liaogx2222/riscv-facerec-soc/提交说明.md

# 工程说明（与赛题提交包同源）

本仓库为**单一 RTL 树**：包含重建全部交付物所需的工程文件。包内默认 RTL 即
五人 QAT 模型配置，直接对应技术报告表4「五人QAT模型版」码流（md5 `b2c404f41db22b83…`）。

## 目录结构

| 目录 | 内容 |
|---|---|
| `rtl/` | 全部 RTL（core 17 / soc 9 / accel 27 / 模型与固件 ROM 15），**默认 = 五人QAT配置** |
| `configs/stable_menu/` | 稳定演示配置的 6 个数据文件（4 模型 ROM + `simple_ram.v` + 仿真金标），按其中 README.txt 覆盖即切换 |
| `constraints/` | 器件/时序/引脚约束（fdc / sdc / pcf，与技术报告表4 码流同一套） |
| `tb/` | 整机与 CoreMark 测试台及金标 |
| `sw/` | 固件 C 源码（门禁 + CoreMark + 菜单） |
| `tools/` | 构建/仿真/校验脚本：`build_flow.py`（一键 RTL→位流）、`synth_vm.py`、`v2_flow.py`、`cmp_sbit.py`、`manifest.py`、`build_menu_fw.py`、`ila_wave.py` 等 |
| `doc/` | 复现手册 `reproduce.md`、时序 `timing.md`、优化 `optimization.md`、权衡 `tradeoff.md` |
| `bitstreams/` | 表4 所列两份最终码流 + `MD5S.txt` |
| `signoff/` | 各配置最终 STA 报告（.rtr）与完整布线资源报告（.rur） |
| `MANIFEST.md` | 输入指纹清单（RTL/约束/固件/测试台 sha256 分组） |

## 复现矩阵（与技术报告表4/表13 对应）

| 码流 | md5 前缀 | 来源 | 包内证据 |
|---|---|---|---|
| facerec_top_menu_line_202p5.sbit（菜单演示版） | `692e2dc77a875` | 开发期候选树工作流（见注） | `signoff/facerec_top_menu_line.rtr/.rur` |
| facerec_top_qat5_202p5.sbit（五人QAT模型版） | `b2c404f41db22b83` | **本包默认配置** | `signoff/facerec_top_qat5.rtr/.rur` |

> 注：菜单版码流由开发期工作流生成（RTL 树已剥离 ILA 观测逻辑），本仓库以码流与 STA 报告的形式提供；
> 其码流与最终 STA 报告作为证据随仓库提供。本包内切到 `configs/stable_menu` 后用同一脚本
> 构建的菜单配置交付树版本时序为 sys +0.260 / cnn +0.126（`All Constraints Met`），
> STA 报告见 `signoff/facerec_top_release_stable.rtr`。

## 快速开始

```bash
# 整机仿真（默认QAT配置，期望 SYSTEM_INTEGRATION_PASS embedding=64/64）
make sim-sys

# 一键 RTL → 位流（2022.2 综合 + 2025.2 布局布线，约 55 分钟）
python tools/build_flow.py rel_build

# 切换到稳定演示配置后构建：先按 configs/stable_menu/README.txt 覆盖 6 个文件，再执行同上命令
```

环境要求与两段式工具链（综合 PDS 2022.2、布局布线 PDS 2025.2）详见 `doc/reproduce.md`。
