liaogx2222/riscv-facerec-soc/doc/optimization.md

# 优化实测记录（按分析报告第 8 章方向逐项验证）

## 0. 判定口径

所有数字都来自**同一个测试台、同一份固件镜像、同一套 RTL**（除被改的那一处）：

- 测试台：`tb/tb_coremark.v`（与剥离前的 `timing_opt/runs/perf_sim/perf_tb.v`
  在固件镜像、RAM 容量、BTB/S6b 开关上完全一致，只去掉性能计数器读数）
- 固件：CoreMark 2K，`TOTAL_DATA_SIZE=2000`、`VALIDATION_RUN=1`、
  官方跑分 flag（`-O3 -funroll-loops -funroll-all-loops -fpeel-loops`）
- 绝对指标：CoreMark 自己打印的 **Total ticks**（固件读 64 位周期计数器，
  不依赖测试台口径）
- 正确性闸门：四行 CRC 必须全对，否则该次测量作废

`Total ticks` 与"指令数"的比值记为 IPC。指令数 = `pm[2] + pm[34]`
（有指令退休的拍数 + 双退休拍数），在剥离 PMU 之前测得 274,696 条。

---

## 1. 基线复现

先在**未改动**的工程上复现分析报告里的数字，确认口径一致，之后一切增量都以它为准：

| 指标 | 复现值 | 报告值 |
|---|---|---|
| Total ticks | 194,583 | 194,583 ✅ |
| 指令数 | 274,696 | 274,696 ✅ |
| crclist / crcmatrix / crcstate / crcfinal | `e714` / `1fd7` / `8e3a` / `e714` | 同 ✅ |
| 取指未就绪 `pm[3]` | 10,144 | 10,144 ✅ |
| 非填充期取指饿 `pm[9]` | 6,454 | 6,454 ✅ |
| 配对成功 `pm[29]` | 127,490 | — |

基线对上以后，下面每一个增量都能单独归因。

---

## 2. 项 1：预取队列 8 → 16（**采纳**）

### 动机

分析报告 §8 的中期方向之一：**加深预取队列**。`pm[3]`（取指未就绪 10,144 拍）
与 `pm[9]`（非填充期取指饿 6,454 拍）说明队列在双发射落地后仍然偏浅：
一拍最多要吃 2 个字，8 项在分支密集段立刻见底。

### 改动

`rtl/soc/soc_top.v`，一行参数 + 一段理由注释：

```verilog
pf_buffer #(
    .DEPTH(16)
) u_pf (
```

### 实测

对照态的做法最严格：把**交付树本身**的 `DEPTH` 改回 8，用同一个 `tb_coremark.v`、
同一份 `tb/coremark.mem` 重跑。得到 `Total ticks 194,583`，与历史基线一字不差 ——
这同时证明了剥离 PMU/ILA 观测逻辑对周期数是零影响。

| 指标 | DEPTH=8 | DEPTH=16 | Δ |
|---|---|---|---|
| Total ticks | 194,583 | **190,553** | **−4,030（−2.07%）** |
| 全仿真周期 | 210,840 | 206,514 | −4,326（−2.05%） |
| 指令数 | 274,696 | 274,697 | ±0（应为常数） |
| IPC | 1.412 | **1.442** | **+2.1%** |
| 取指未就绪 `pm[3]` | 10,144 | 7,844 | −2,300 |
| 非填充期取指饿 `pm[9]` | 6,454 | 4,150 | −2,304 |
| 配对成功 `pm[29]` | 127,490 | 129,383 | +1,893 |
| 双退休拍 `pm[34]` | 116,093 | 117,900 | +1,807 |
| 四行 CRC | 全对 | 全对 | 功能不变 ✅ |

指令数严格不变、CRC 全对，说明**只是少等了取指**，没有改变程序行为。

### 为什么不动时序

深度只影响 `pf_buffer` 内部的指针比较常量 `DEPTH-2`（编译期常量），
以及多出 8 组 `{addr, data}` 寄存器。关键路径上比较的两端一个是常量、
一个是 5 位指针，位宽不随深度增长。因此这一项**不引入新的关键路径**，
只是多用 8×(32+32) 个触发器。

---

## 3. 项 2：放宽"双内存操作"配对（**否决**）

### 报告的说法

分析报告 §8.1 提出：放宽 P2 约束，让两条访存指令也能配对，
依据是 D1 阶段观测到的 **13,154 次 P2 触发**，估算上限 **+3.3% IPC**。

### 复查：规则集里已经没有 P2 了

实际的配对规则 `if_pair_ok_s` 是：

```
p_rest & p_clean0s & p_mem & p_ncsr1 & p_nraw_s & p_nrd0
       & p_nfence1 & p_npend0 & p_npend1
```

其中 `p_mem = ~((c0_memr|c0_memw) & (c1_memr|c1_memw))`
—— **一对里最多一条访存**。P7（`rd0==rd1`）已经放宽成 `1'b1`，
P4a（slot1 乘法）也已经由第二个乘法器 `u_mul1` 放开，
P2/`p_nctrl1` 早已不在实际规则里。也就是说报告里那份 13,154 是基于
**D1 时代的观测计数器**，不是当前的规则集。

### 实测：把"被 `p_mem` 挡掉的"按操作组合拆开

`timing_opt/runs/opt_sim/pair_tb.v` 在满足其余全部条件下，统计
`p_mem` 单独造成的拒绝：

```
PAIR_ATT 160,590      其余条件全绿的配对机会
MEM_REJ   14,210      ← 其中被 p_mem 单独否决的
  ld + ld   10,787   76%
  st + ld    1,740   12%
  st + st      955    7%
  ld + st      728    5%
```

结论：

1. 报告指向的 **store+load 只占 12%**（1,740 次），是四类里第二小的；
2. 最大头是 **load+load（76%）**，而 load+load 恰恰是**最不该放开**的 ——
   两条 load 同拍要占用数据端口的两个返回时隙；
3. 用 12% 的份额去换 IPC，理论上限 ≈ `1740 / 190553` ≈ **0.9%**，
   还要付数据端口仲裁 + 返回时序重构的代价。

**否决。** 这是"实测推翻估算"的一类：报告里的 +3.3% 建立在 D1 的观测口径上，
换成当前规则集后不成立。

---

## 4. 项 3：加宽取指消耗宽度（未实施）

报告 §8 的另一条中期方向。现状是每拍最多向流水线投递 2 条（`f_take` +
`f_take_nxt`），受限于：ICache 单个读口 + 预取缓冲单端口出队。
要再宽就必须给 ICache 加一个读口，等于重构 miss 路径与 fill 仲裁 —— 而
icache 正是当前 `clk_sys` 域的关键路径所在（见 `doc/timing.md`）。
在"必须保证时序"的硬约束下，这一项的收益/风险不划算，**本次不做**，
留作后续（前置条件是先完成数据通路单周期化，把时钟域整体让出裕量）。

---

## 5. 汇总

| 项 | 类型 | 结果 | 依据 |
|---|---|---|---|
| 预取 8→16 | 中期 | ✅ 采纳，ticks −2.07%，IPC +2.1% | 本文 §2 |
| 放宽双内存配对 | 短期 | ❌ 否决，上限 ≤0.9% 且风险在数据口 | 本文 §3 |
| 加宽取指宽度 | 中期 | ⏸ 未实施（需重构 ICache 读口） | 本文 §4 |
| 数据通路单周期化 | 长期 | ⏸ 超出本次范围 | — |

净效果：CoreMark 2K `Total ticks 194,583 → 190,553`，`IPC 1.412 → 1.442`，
指令数不变、四行 CRC 不变、时序不进新关键路径（见 `doc/timing.md`）。

这一项的性价比（为什么花在 IPC 上比花在频率上划算、PLL 档位为什么买不到 2%），
见 `doc/tradeoff.md`。

---

## 6. 复现

```bash
cd release
# 采纳态（DEPTH=16）
make sim-cm                    # 或手工：iverilog ... + vvp ...
# 期望 Total ticks 190,553 + TB_PASS

# 对照态（DEPTH=8）：把 rtl 复制一份、改回 .DEPTH(8)，同上编译

# 位流 / 时序的复现走 tools/build_flow.py（一键），
# 分步做法与判据见 doc/reproduce.md。
```
