liaogx2222/riscv-facerec-soc/doc/tradeoff.md

# 频率 ↔ 性能的 tradeoff（含本轮优化的实测归因）

## 0. 一句话结论

这颗芯片的频率**已经签核到布线级**（`All Constraints Met.`，CPU +4.16% / CNN +2.34%
的周期余量），但**再往上走一步是买不到的** —— PLL 的下一档是 +6.67%，一步就跨过了
全部余量。所以这轮性能只能从 IPC 里拿：预取队列 8→16 换来 **+2.07%**，
等于把频率从 101.25 抬到 **103.39 MHz**，而频率预算**一分没动**。

---

## 1. 性能的两个乘数

一輪 CoreMark 2K 的墙钟时间：

```
T = ticks / f = (指令数 / IPC) / f
```

- `ticks`（= 190,553）由微架构决定，改 RTL 才能动；
- `f` 由关键路径 + 布局布线 + **PLL 分频比**共同决定。

两者在分数上等价：`f` 提 2.07% 与 `ticks` 降 2.07%，CoreMark 分数完全一样
（`CM/MHz = 1e6/ticks`，`分数 = CM/MHz × f`）。所以真正的问题是"哪一种买得到"。

| 路径 | 手段 | 收益 | 代价 |
|---|---|---|---|
| 买频率 | 把 101.25 抬到 103.4 MHz | +2.07% | 需要 **+2.07%** 周期余量，且 PLL 必须能出这个频点 |
| 买 IPC | 预取队列 8→16 | +2.07% | 512 个触发器，关键路径不变 |

下面两节分别算这两笔账，结论是**第二笔买得到，第一笔买不到**。

---

## 2. 频率那一侧：有余量，但没有"台阶"

### 2.1 余量（布线签核实测，2025.2 引擎）

| 时钟 | 请求 | 实测 | 周期余量 | 折算频率余量 |
|---|---|---|---|---|
| `clk_sys` | 9.8765 ns（101.25 MHz） | **9.4815 ns** | **+0.395 ns** | 105.47 MHz，**+4.16%** |
| `clk_cnn` | 4.9383 ns（202.5 MHz） | **4.8253 ns** | **+0.113 ns** | 207.24 MHz，**+2.34%** |

余量是真实存在的（不是"欠 80 ps"——那个数字来自 2022.2 引擎的一次
`-place_only` 筛选，跨引擎不可比，见 `doc/timing.md` §4）。

### 2.2 但频率是"量子化"的

PLL 是硬连线整数分频：`VCO = 27 MHz × M × F`（F 按 1/8 步进，VCO ∈ [600, 1200]），
`clk_sys = VCO/8`、`clk_cnn = VCO/4`（严格 2:1）。当前 `M=10, F=3 → VCO 810`。

往上找最近的合法档：

| VCO | M / F | clk_sys | 相对 101.25 | 需要 CPU 余量 | 需要 CNN 余量 |
|---|---|---|---|---|---|
| **810（当前）** | 10 / 3.0 | 101.25 MHz | — | 0 | 0 |
| **864** | **8 / 4.0** | **108.00 MHz** | **+6.67%** | 6.67% > 4.16% ❌ | 6.67% > 2.34% ❌ |
| 891 | 11 / 3.0 | 111.375 MHz | +10.0% | ❌ | ❌ |
| 1080 | 10 / 4.0 | 135.00 MHz | +33.3% | ❌ | ❌ |

**最小的可用台阶是 +6.67%，而余量只有 +4.16%（CPU）/ +2.34%（CNN）。**
也就是说：频率不是"能提多少提多少"，而是要么原地不动，要么一步跳到 108 MHz
然后把余量烧穿。**这条路上没有 2% 的增量可买。**

（顺带解释了为什么 148.5/297 MHz 这个档位也走不通：`VCO=1188` 是最高合法档，
但 297 MHz 需要 3.367 ns、实测最好 4.8253 ns，差 43%；而且把约束压紧到 297，
CNN 反而从 4.8253 退化到 5.1750 —— 无解区间里约束收紧是负收益。）

### 2.3 结论

频率这一侧的正确用法不是"再挤一点"，而是"**守住已签核的余量**"：
+0.395 / +0.113 ns 是布线后剩下来的安全垫，用来吸收温度、电压、
以及后续任何一处改动的扰动。拿它去换 2% 的分数，等于把安全垫烧掉，
换来的只是一次跳档失败的风险。

---

## 3. IPC 那一侧：这才是可增量购买的性能

| 项 | 基线 | 优化后 | Δ |
|---|---|---|---|
| Total ticks | 194,583 | **190,553** | **−4,030（−2.07%）** |
| 指令数 | 274,696 | 274,697 | ±0（应为常数） |
| IPC | 1.4117 | **1.4416** | **+2.12%** |
| CM/MHz（=1e6/ticks） | 5.1392 | **5.2479** | +2.12% |
| 分数 @101.25 MHz | 520.3 | **531.3** | +11.0 |
| 分数 @27 MHz | 138.8 | 141.7 | +2.9 |

换算成"等价的频率"：**103.39 MHz**。也就是说，这一项优化让设计在
101.25 MHz 上跑出了 103.39 MHz 的分数，而没有向时序要任何东西：

- 关键路径上 `pf_buffer` 比较的是**编译期常量** `DEPTH-2`，另一侧是 5 位指针，
  位宽不随深度增长 ⇒ 不产生新的关键路径；
- 新增硬件 = 8 组 `{addr,data}` = **512 个 FF**，BRAM 数量不变；
- 副作用全是好的：取指未就绪 10,144→7,844 拍、非填满期取指饿 6,454→4,150 拍。

在频率-性能这张图上，它是**纯向右平移**（性能↑，频率不变），
而不是沿着曲线滑动。

---

## 4. 三个档位，各自的代价

| 档位 | CPU / CNN | CoreMark 一轮 | 6000 次迭代 | 时序状态 | 定位 |
|---|---|---|---|---|---|
| **产品（签核）** | 101.25 / 202.5 MHz | 1.882 ms | ≈11.3 s | ✅ 布线 `All Constraints Met.`（+0.395 / +0.113） | 正式参赛/演示 |
| **27 MHz 保底** | 27 / 27 MHz（PLL 旁路） | 7.058 ms | ≈42.3 s | ✅ 仅 CPU-only 签核过（+14.080 ns） | 现场救急 |
| **CNN 降频** | 101.25 / ≈204 MHz | 1.882 ms | ≈11.3 s | ✅ 若需要把 CNN 余量再加厚 | 备选 |

27 MHz 的账很清楚：周期是产品的 **3.75 倍**，同一份 RTL/固件 CoreMark 一轮
从 1.88 ms 变 7.06 ms，分数从 531 掉到 142（**−73%**）。它的价值不在分数，
在于"一定能跑起来"：PLL 一旦不锁、或高频不收敛，这是唯一还能演示的路径。
赛题要求"单次跑分 ≥10 s"，6000 次迭代在 27 MHz 下 ≈42.3 s，**仍然满足**
（那是下限约束，降频不违规，只是分数低）。

---

## 5. 被否决的那一项，恰好是"收益小、还要动频率"

报告 §8.1 建议放宽"双内存操作"配对。实测把 `p_mem` 单独造成的 14,210 次
拒绝拆开：`ld+ld 10,787（76%）/ st+ld 1,740（12%）/ st+st 955 / ld+st 728`。

- 理论收益上限 ≈ 1,740 / 190,553 ≈ **0.9%**（不到预取那一项的一半）；
- 代价是要让两条访存同拍占用数据端口：返回时隙仲裁、转发优先级、store buffer
  入队条件全部要重排 —— 这些**全在 `clk_sys` 的关键路径上**。

它同时做了两件坏事：收益更小，且**可能把 +0.395 ns 的安全垫吃掉**。
在"必须保证时序"的前提下，正确结论是**否决**，而不是"下次再做"。

---

## 6. 如果还要继续提性能，按这个顺序

| 优先级 | 手段 | 预期收益 | 频率代价 | 风险 |
|---|---|---|---|---|
| 1 | ICache 加第二读口 / 加宽取指消耗 | 争取再 +2~3% IPC | **升高**（icache 在 `clk_sys` 关键路径上） | 中，需重构 miss/fill 仲裁 |
| 2 | 数据通路单周期化（报告 §8 长期项） | 为 1 腾出裕量 | 中性偏降 | 高，等于重做访存流水 |
| 3 | PE 阵列再插流水冲更高 CNN 频率 | CNN 频率 +1.6% 量级 | 降低 | 高，黄金向量要全量回归 |
| — | 改 PLL 分频比直接跳档（108 MHz） | 名义 +6.67% | **超出余量** | 会直接失败，不可行 |

顺序原则：**先动"占频率预算"的改造（1/2），再谈频率；永远不要用"把约束
压紧"来提频** —— 2022.2/2025.2 两次实测都表明在无解区间收紧约束是负收益
（202.5→297，CNN 从 4.8253 退化到 5.1750）。

---

## 7. 落到数字上的总结

```
优化前：194,583 ticks @ 101.25 MHz = 1.9218 ms/轮，IPC 1.4117，分数 520.3
优化后：190,553 ticks @ 101.25 MHz = 1.8820 ms/轮，IPC 1.4416，分数 531.3
```

- 性能 **+2.07%**，等价于 **103.39 MHz**；
- 频率一分没多花（仍是签核的 101.25 / 202.5，余量 +0.395 / +0.113 ns 未动）；
- 指令数 274,696 → 274,697（不变）、四行 CRC 全对（功能不变）；
- 面积 +512 FF；BRAM 不变；关键路径不变。

一句话：**这轮优化的本质，是把"本来要一次跳档 +6.67% 才能买到的性能"，
用 512 个触发器换了回来。** 签核余量一分没动，留给后面真正需要动频率的改造。
