liaogx2222/riscv-facerec-soc/rtl/accel/cnn_linebuf.v

// Banked 4-row line buffer, derived from FaceRec_SoC cnn_linebuf.
// Four logical rows x three interleaved column banks; one read per bank.
// Payload RAM is reset-free; per-word validity implements synchronous clear.
// 3x3 and PW windows remain combinational, with the original cycle protocol.
// Eight-bit coordinate quotient/remainder uses a complete constant lookup,
// avoiding runtime signed division/modulo unsupported by PDS ADS.
// PW selects the center row and wraps c to WAW bits as in the source design.
// Source provenance and equivalence/resource evidence are in doc/ and build/.
`timescale 1ns/1ps

(* syn_romstyle="logic" *) module cnn_linebuf #(
    parameter CH   = 32,
    parameter AW   = 8,
    parameter MAXW = 128,
    parameter TAPS = 9,
    parameter WAW  = 7,           // 列地址位宽（MAXW=128 ⇒ 7）
    parameter RAW  = 9            // 行缓冲地址位宽（4*MAXW=512 ⇒ 9）
)(
    input  wire                    clk,
    input  wire                    rst_n,
    input  wire                    clr,          // 层首/复位：整组清零 + rot_p 归零
    input  wire                    win_top_zero, // 输出行 r==0：窗口顶行（输入行 -1）强制零
    input  wire                    win_bot_zero, // ★ 窗口底行（输入行 r+1 ≥ ih）强制零
                                                 //   —— stride-1 末输出行的底行越界，
                                                 //     调度器仍会装载（读 ACT 越界地址，
                                                 //     数据被这里掩掉），拍数不变
    input  wire                    mode_pw,      // ★ 1 = 1×1 层：窗口退化为 1×1（9 tap 同一列字）
    input  wire                    rot_step2,    // ★ 1 = 每次 rot 前进 2 行（stride-2）；0 = 前进 1 行
    input  wire                    wld,          // 装载一拍（写 row_buf[ldst][waddr]）
    input  wire [1:0]              ldst,         // 装载目标物理行（0..3）
    input  wire [WAW-1:0]          waddr,        // 装载列地址
    input  wire [CH*AW-1:0]        newword,      // 装载数据（CH 字节）
    input  wire                    rot,          // 行旋转
    input  wire [7:0]              iw,           // 本层行宽（运行时；★M8 拓到 8 位）
    input  wire [7:0]              c,            // 当前输出像素列（0..iw-1）
    output wire [1:0]              rot_p_o,      // 行环指针（控制器算装载目标用）
    output reg  [TAPS*CH*AW-1:0]   win           // 组合窗口输出
);

    // Complete eight-bit quotient/remainder table: no runtime div/mod.
    function [8:0] divmod3;
        input [7:0] x;
        begin
            case(x)
                8'd0: divmod3=9'd0;
                8'd1: divmod3=9'd1;
                8'd2: divmod3=9'd2;
                8'd3: divmod3=9'd4;
                8'd4: divmod3=9'd5;
                8'd5: divmod3=9'd6;
                8'd6: divmod3=9'd8;
                8'd7: divmod3=9'd9;
                8'd8: divmod3=9'd10;
                8'd9: divmod3=9'd12;
                8'd10: divmod3=9'd13;
                8'd11: divmod3=9'd14;
                8'd12: divmod3=9'd16;
                8'd13: divmod3=9'd17;
                8'd14: divmod3=9'd18;
                8'd15: divmod3=9'd20;
                8'd16: divmod3=9'd21;
                8'd17: divmod3=9'd22;
                8'd18: divmod3=9'd24;
                8'd19: divmod3=9'd25;
                8'd20: divmod3=9'd26;
                8'd21: divmod3=9'd28;
                8'd22: divmod3=9'd29;
                8'd23: divmod3=9'd30;
                8'd24: divmod3=9'd32;
                8'd25: divmod3=9'd33;
                8'd26: divmod3=9'd34;
                8'd27: divmod3=9'd36;
                8'd28: divmod3=9'd37;
                8'd29: divmod3=9'd38;
                8'd30: divmod3=9'd40;
                8'd31: divmod3=9'd41;
                8'd32: divmod3=9'd42;
                8'd33: divmod3=9'd44;
                8'd34: divmod3=9'd45;
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
                8'd218: divmod3=9'd290;
                8'd219: divmod3=9'd292;
                8'd220: divmod3=9'd293;
                8'd221: divmod3=9'd294;
                8'd222: divmod3=9'd296;
                8'd223: divmod3=9'd297;
                8'd224: divmod3=9'd298;
                8'd225: divmod3=9'd300;
                8'd226: divmod3=9'd301;
                8'd227: divmod3=9'd302;
                8'd228: divmod3=9'd304;
                8'd229: divmod3=9'd305;
                8'd230: divmod3=9'd306;
                8'd231: divmod3=9'd308;
                8'd232: divmod3=9'd309;
                8'd233: divmod3=9'd310;
                8'd234: divmod3=9'd312;
                8'd235: divmod3=9'd313;
                8'd236: divmod3=9'd314;
                8'd237: divmod3=9'd316;
                8'd238: divmod3=9'd317;
                8'd239: divmod3=9'd318;
                8'd240: divmod3=9'd320;
                8'd241: divmod3=9'd321;
                8'd242: divmod3=9'd322;
                8'd243: divmod3=9'd324;
                8'd244: divmod3=9'd325;
                8'd245: divmod3=9'd326;
                8'd246: divmod3=9'd328;
                8'd247: divmod3=9'd329;
                8'd248: divmod3=9'd330;
                8'd249: divmod3=9'd332;
                8'd250: divmod3=9'd333;
                8'd251: divmod3=9'd334;
                8'd252: divmod3=9'd336;
                8'd253: divmod3=9'd337;
                8'd254: divmod3=9'd338;
                8'd255: divmod3=9'd340;
                default: divmod3=9'bxxxxxxxxx;
            endcase
        end
    endfunction

    localparam DW = CH*AW;
    localparam BANK_DEPTH = (MAXW+2)/3;
    localparam BAW = BANK_DEPTH>1 ? $clog2(BANK_DEPTH) : 1;
    reg [1:0] rot_p;
    assign rot_p_o=rot_p;
    always @(posedge clk) begin
        if (!rst_n || clr) rot_p<=0;
        else if (rot) rot_p<=rot_p+(rot_step2 ? 2'd2 : 2'd1);
    end

    // Each physical row has three interleaved column banks. Three adjacent
    // columns use different banks, so every payload array needs one read.
    wire [7:0] ci=mode_pw ? c[WAW-1:0] : c;
    wire [8:0] read_divmod=divmod3(ci);
    wire [6:0] cq=read_divmod[8:2];
    wire [1:0] cr=read_divmod[1:0];
    // Move every RAM operation one edge together. Delaying just the read
    // address would change same-address read/write and clear semantics.
    reg memory_reset_q,memory_clear_q,write_load_q;
    reg [1:0] write_row_q;
    // The original binary address shadow let ADS retime this table into
    // a synchronous DRM ROM. Capture its decoded result in fabric instead.
    wire [8:0] write_decode=divmod3(waddr);
    (* syn_preserve=1, syn_romstyle="logic" *) reg [8:0] write_decode_q;
    (* syn_preserve=1 *) reg write_in_range_q;
    reg [DW-1:0] write_word_q;
    always @(posedge clk)begin
        memory_reset_q<=rst_n;memory_clear_q<=clr;write_load_q<=wld;
        write_row_q<=ldst;write_decode_q<=write_decode;
        write_in_range_q<=waddr<MAXW;write_word_q<=newword;
    end
    wire [8:0] write_divmod=write_decode_q;
    wire [6:0] write_idx=write_divmod[8:2];
    wire [1:0] write_bank=write_divmod[1:0];
    wire [12*DW-1:0] bank_word;
    wire [11:0] bank_valid;
    genvar row,bank;
    generate for(row=0;row<4;row=row+1) begin:g_row
        // Keep the scalar validity address off the 256-bit payload fanout.
        wire [3*BAW-1:0] valid_read_indexes;
        // ADS compiles away equivalent instances despite syn_hier="hard".
        // Official syn_noprune is verified by the decoder attribute probe.
        (* syn_noprune=1 *) cnn_linebuf_read_addr #(.WAW(WAW),.BANK_DEPTH(BANK_DEPTH),.BAW(BAW)) u_valid_addr(
            .c(c),.mode_pw(mode_pw),.indexes(valid_read_indexes));
        wire [3*BAW-1:0] row_read_indexes;
        cnn_linebuf_read_addr #(.WAW(WAW),.BANK_DEPTH(BANK_DEPTH),.BAW(BAW)) u_addr(
            .c(c),.mode_pw(mode_pw),.indexes(row_read_indexes));
        (* syn_preserve=1 *) reg [3*BAW-1:0] payload_indexes_q;
        (* syn_preserve=1 *) reg [3*BAW-1:0] validity_indexes_q;
        always @(posedge clk)begin
            payload_indexes_q<=row_read_indexes;
            validity_indexes_q<=valid_read_indexes;
        end
        for(bank=0;bank<3;bank=bank+1) begin:g_bank
            reg [DW-1:0] payload[0:BANK_DEPTH-1] /* synthesis syn_ramstyle="select_ram" */;
            reg [BANK_DEPTH-1:0] valid;
            wire wen=write_load_q && write_row_q==row && write_bank==bank && write_in_range_q;
            always @(posedge clk)
                if(memory_reset_q && !memory_clear_q && wen) payload[write_idx[BAW-1:0]]<=write_word_q;
            always @(posedge clk) begin
                if(!memory_reset_q || memory_clear_q) valid<=0;
                else if(wen) valid[write_idx[BAW-1:0]]<=1'b1;
            end
            reg [DW-1:0] read_q;
            reg read_valid_q;
            // Sample payload and its validity at the same edge. Applying
            // the zero mask afterwards preserves read-before-write and
            // four-state semantics, without a wide synchronous-reset cone.
            always @(posedge clk) begin
                read_q <= payload[payload_indexes_q[bank*BAW+:BAW]];
                read_valid_q <= valid[validity_indexes_q[bank*BAW+:BAW]];
            end
            assign bank_word[(row*3+bank)*DW +: DW]=read_q;
            assign bank_valid[row*3+bank]=read_valid_q;
        end
    end endgenerate

    // Register decoded selectors/masks alongside the bank data. Boundary
    // comparison and coordinate arithmetic no longer precede DSP input setup.
    localparam NREADROWS=(TAPS+2)/3;
    reg [1:0] row_d[0:NREADROWS-1],row_q[0:NREADROWS-1];
    reg [1:0] col_d[0:2],col_q[0:2];
    integer init_i;
    reg [TAPS-1:0] keep_d,keep_q;
    integer t,tr,tc,bank_tmp,scol;
    reg [1:0] physical_row,column_bank;
    reg [3:0] data_index;
    always @(*) begin
        keep_d=0;tr=0;tc=0;physical_row=0;column_bank=0;
        bank_tmp=0;scol=0;data_index=0;
        for(init_i=0;init_i<NREADROWS;init_i=init_i+1)row_d[init_i]=0;
        for(init_i=0;init_i<3;init_i=init_i+1)col_d[init_i]=0;
        for(t=0;t<TAPS;t=t+1) begin
            tr=t/3;tc=t%3;
            if(mode_pw) begin
                physical_row=(rot_p+1)&3;column_bank=cr;
                data_index={physical_row,1'b0}+physical_row+column_bank;
                row_d[tr]=physical_row;col_d[tc]=column_bank;keep_d[t]=1'b1;
            end else begin
                physical_row=(rot_p+tr)&3;
                bank_tmp=cr+tc-1;
                if(bank_tmp<0) bank_tmp=bank_tmp+3;
                if(bank_tmp>=3) bank_tmp=bank_tmp-3;
                column_bank=bank_tmp[1:0];scol=ci+tc-1;
                data_index={physical_row,1'b0}+physical_row+column_bank;
                row_d[tr]=physical_row;col_d[tc]=column_bank;
                // Procedural if preserves the reference's four-state mask
                // behavior, including unknown boundary control inputs.
                if((win_top_zero && tr==0)||(win_bot_zero && tr==2)||scol<0||scol>=iw)
                    keep_d[t]=1'b0;
                else keep_d[t]=1'b1;
            end
        end
    end
    reg [1:0] row_index_q[0:NREADROWS-1],col_index_q[0:2];
    reg [TAPS-1:0] keep_index_q;
    integer k;
    always @(posedge clk) begin
        for(k=0;k<NREADROWS;k=k+1)begin row_index_q[k]<=row_d[k];row_q[k]<=row_index_q[k];end
        for(k=0;k<3;k=k+1)begin col_index_q[k]<=col_d[k];col_q[k]<=col_index_q[k];end
        keep_index_q<=keep_d;keep_q<=keep_index_q;
    end
    reg [1:0] col_pipe_q[0:2];
    reg [TAPS-1:0] keep_pipe_q;
    integer pipe_col;
    always @(posedge clk)begin
        for(pipe_col=0;pipe_col<3;pipe_col=pipe_col+1)col_pipe_q[pipe_col]<=col_q[pipe_col];
        keep_pipe_q<=keep_q;
    end
    wire [TAPS*DW-1:0] window_word;
    genvar rr,bb,cc;
    generate for(rr=0;rr<NREADROWS;rr=rr+1)begin:g_read_row
        wire [3*DW-1:0] logical_banks;
        reg [3*DW-1:0] logical_banks_q;
        always @(posedge clk)logical_banks_q<=logical_banks;
        for(bb=0;bb<3;bb=bb+1)begin:g_read_bank
            cnn_lb_row_pick #(.DW(DW)) u_pick(
                .words({bank_word[(9+bb)*DW+:DW],bank_word[(6+bb)*DW+:DW],
                        bank_word[(3+bb)*DW+:DW],bank_word[bb*DW+:DW]}),
                .valids({bank_valid[9+bb],bank_valid[6+bb],bank_valid[3+bb],bank_valid[bb]}),
                .sel(row_q[rr]),.value(logical_banks[bb*DW+:DW]));
        end
        for(cc=0;cc<3;cc=cc+1)begin:g_read_col
            if(rr*3+cc<TAPS)begin:g_tap
                cnn_lb_col_pick #(.DW(DW)) u_pick(.words(logical_banks_q),
                    .sel(col_pipe_q[cc]),.value(window_word[(rr*3+cc)*DW+:DW]));
            end
        end
    end endgenerate
    integer o;
    always @(*) begin
        win=0;
        for(o=0;o<TAPS;o=o+1) begin
            if(!keep_pipe_q[o]) win[o*DW+:DW]=0;
            else win[o*DW+:DW]=window_word[o*DW+:DW];
        end
    end
endmodule

// Final bank indexes are constant functions of c and PW wrap semantics.
module cnn_linebuf_read_addr /* synthesis syn_hier="hard" */ #(
    parameter WAW=7,BANK_DEPTH=43,BAW=6)(
    input wire [7:0] c,input wire mode_pw,output wire [3*BAW-1:0] indexes);
    function [BAW-1:0] bound;
        input integer n;
        begin if(n>=0 && n<BANK_DEPTH)bound=n;else bound=0;end
    endfunction
    function [3*BAW-1:0] decode_read;
        input [7:0] coordinate;input pw;
        begin
        case({pw,coordinate})
            9'd0:decode_read={bound(-1),bound(0),bound(0)};
            9'd1:decode_read={bound(0),bound(0),bound(0)};
            9'd2:decode_read={bound(0),bound(0),bound(1)};
            9'd3:decode_read={bound(0),bound(1),bound(1)};
            9'd4:decode_read={bound(1),bound(1),bound(1)};
            9'd5:decode_read={bound(1),bound(1),bound(2)};
            9'd6:decode_read={bound(1),bound(2),bound(2)};
            9'd7:decode_read={bound(2),bound(2),bound(2)};
            9'd8:decode_read={bound(2),bound(2),bound(3)};
            9'd9:decode_read={bound(2),bound(3),bound(3)};
            9'd10:decode_read={bound(3),bound(3),bound(3)};
            9'd11:decode_read={bound(3),bound(3),bound(4)};
            9'd12:decode_read={bound(3),bound(4),bound(4)};
            9'd13:decode_read={bound(4),bound(4),bound(4)};
            9'd14:decode_read={bound(4),bound(4),bound(5)};
            9'd15:decode_read={bound(4),bound(5),bound(5)};
            9'd16:decode_read={bound(5),bound(5),bound(5)};
            9'd17:decode_read={bound(5),bound(5),bound(6)};
            9'd18:decode_read={bound(5),bound(6),bound(6)};
            9'd19:decode_read={bound(6),bound(6),bound(6)};
            9'd20:decode_read={bound(6),bound(6),bound(7)};
            9'd21:decode_read={bound(6),bound(7),bound(7)};
            9'd22:decode_read={bound(7),bound(7),bound(7)};
            9'd23:decode_read={bound(7),bound(7),bound(8)};
            9'd24:decode_read={bound(7),bound(8),bound(8)};
            9'd25:decode_read={bound(8),bound(8),bound(8)};
            9'd26:decode_read={bound(8),bound(8),bound(9)};
            9'd27:decode_read={bound(8),bound(9),bound(9)};
            9'd28:decode_read={bound(9),bound(9),bound(9)};
            9'd29:decode_read={bound(9),bound(9),bound(10)};
            9'd30:decode_read={bound(9),bound(10),bound(10)};
            9'd31:decode_read={bound(10),bound(10),bound(10)};
            9'd32:decode_read={bound(10),bound(10),bound(11)};
            9'd33:decode_read={bound(10),bound(11),bound(11)};
            9'd34:decode_read={bound(11),bound(11),bound(11)};
            9'd35:decode_read={bound(11),bound(11),bound(12)};
            9'd36:decode_read={bound(11),bound(12),bound(12)};
            9'd37:decode_read={bound(12),bound(12),bound(12)};
            9'd38:decode_read={bound(12),bound(12),bound(13)};
            9'd39:decode_read={bound(12),bound(13),bound(13)};
            9'd40:decode_read={bound(13),bound(13),bound(13)};
            9'd41:decode_read={bound(13),bound(13),bound(14)};
            9'd42:decode_read={bound(13),bound(14),bound(14)};
            9'd43:decode_read={bound(14),bound(14),bound(14)};
            9'd44:decode_read={bound(14),bound(14),bound(15)};
            9'd45:decode_read={bound(14),bound(15),bound(15)};
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
            9'd509:decode_read={bound(((8'd253 & ((1<<WAW)-1))/3)),bound(((8'd253 & ((1<<WAW)-1))/3)),bound(((8'd253 & ((1<<WAW)-1))/3))};
            9'd510:decode_read={bound(((8'd254 & ((1<<WAW)-1))/3)),bound(((8'd254 & ((1<<WAW)-1))/3)),bound(((8'd254 & ((1<<WAW)-1))/3))};
            9'd511:decode_read={bound(((8'd255 & ((1<<WAW)-1))/3)),bound(((8'd255 & ((1<<WAW)-1))/3)),bound(((8'd255 & ((1<<WAW)-1))/3))};
            default:decode_read={3*BAW{1'bx}};
        endcase
        end
    endfunction
    assign indexes=decode_read(c,mode_pw);
endmodule

// Shared 4:1 row selection precedes the three column selections. Keeping
// this hierarchy stops a separate 12:1 mux being rebuilt for every tap.
module cnn_lb_row_pick /* synthesis syn_hier="hard" */ #(parameter DW=256)(
    input wire [4*DW-1:0] words,input wire [3:0] valids,
    input wire [1:0] sel,output wire [DW-1:0] value);
    wire [DW-1:0] raw=words[sel*DW+:DW];
    assign value=valids[sel]?raw:{DW{1'b0}};
endmodule
module cnn_lb_col_pick /* synthesis syn_hier="hard" */ #(parameter DW=256)(
    input wire [3*DW-1:0] words,input wire [1:0] sel,
    output wire [DW-1:0] value);
    assign value=words[sel*DW+:DW];
endmodule
