liaogx2222/riscv-facerec-soc/sw/gate_core.c

// =====================================================================
// gate_core.c —— 门禁编排的纯逻辑实现（与 Python golden 逐位一致）
// =====================================================================
#include "gate_core.h"

// ---------------------------------------------------------------------
// 框解码
//
// 对照 hwnet.decode_box：
//     cx = round(ax*A) + qx*STEP_C*aw
//     w  = (aw*A*lut[qw+128]) >> q
//     x1 = (cx - (w>>1)) >> q
//     x2 = (cx + (w>>1) + A - 1) >> q
//
// ★ 关键化简（本工程 FIXQ=20，A=1<<q）：
//       (aw*A*lut) >> q  ==  aw*lut        （精确相等，不是近似）
//   ⇒ 尺寸项不需要 64 位乘法。实测最大 aw*lut = 256*5,129,115 = 1.31e9，
//     仍在 int32 内（2.15e9），但 cx + (w>>1) + A 会到 ~1.0e9 —— 也安全。
//   若将来 q 改小或 oc 变大导致 aw*lut 溢出，这里必须换 64 位。
// ---------------------------------------------------------------------
void g_decode(const gdec_t *dec, int32_t ax_q, int32_t ay_q,
              int32_t aw, int32_t ah,
              int qx, int qy, int qw, int qh,
              int16_t *ox1, int16_t *oy1, int16_t *ox2, int16_t *oy2)
{
    const int32_t A = (int32_t)1 << dec->q;
    int32_t cx = ax_q + qx * dec->step_c * aw;
    int32_t cy = ay_q + qy * dec->step_c * ah;
    int32_t w  = aw * dec->lut[qw + 128];
    int32_t h  = ah * dec->lut[qh + 128];
    int32_t hw = w >> 1;
    int32_t hh = h >> 1;

    // Python 的 >> 对负数是 floor，C 的算术右移也是 floor ⇒ 一致
    *ox1 = (int16_t)((cx - hw) >> dec->q);
    *oy1 = (int16_t)((cy - hh) >> dec->q);
    *ox2 = (int16_t)((cx + hw + A - 1) >> dec->q);
    *oy2 = (int16_t)((cy + hh + A - 1) >> dec->q);
}

// ---------------------------------------------------------------------
// IoU ×1000
//   与 Python 的 `inter/union <= thr`（浮点）等价：
//   两边都是整数，所以 inter/union 是有理数；用
//       inter*1000 <= thr_milli*union
//   做精确整数比较，不会引入浮点舍入（thr=0.40 时 thr_milli=400）。
// ---------------------------------------------------------------------
int32_t g_iou_milli(int ax1, int ay1, int ax2, int ay2,
                    int bx1, int by1, int bx2, int by2)
{
    int iw = (ax2 < bx2 ? ax2 : bx2) - (ax1 > bx1 ? ax1 : bx1);
    int ih = (ay2 < by2 ? ay2 : by2) - (ay1 > by1 ? ay1 : by1);
    int32_t inter, uni;
    if (iw <= 0 || ih <= 0)
        return 0;
    inter = (int32_t)iw * ih;
    uni = (int32_t)(ax2 - ax1) * (ay2 - ay1)
        + (int32_t)(bx2 - bx1) * (by2 - by1) - inter;
    if (uni <= 0)
        return 0;
    return (int32_t)(((int64_t)inter * 1000) / uni);
}

// ---------------------------------------------------------------------
// 贪心 NMS（与 hwnet.nms 一致：按 d 降序，IoU <= thr 保留）
//   为了在 RV32 上避免浮点，比较用 g_iou_milli
// ---------------------------------------------------------------------
int g_nms(gbox_t *b, int n, int thr_milli)
{
    int i, j, m = 0;
    gbox_t t;
    // 插入排序（n <= 54，比调用 qsort 省栈、省代码）
    for (i = 1; i < n; i++) {
        t = b[i];
        for (j = i - 1; j >= 0 && b[j].d < t.d; j--)
            b[j + 1] = b[j];
        b[j + 1] = t;
    }
    for (i = 0; i < n; i++) {
        int keep = 1;
        for (j = 0; j < m; j++) {
            if (g_iou_milli(b[i].x1, b[i].y1, b[i].x2, b[i].y2,
                            b[j].x1, b[j].y1, b[j].x2, b[j].y2) > thr_milli) {
                keep = 0;
                break;
            }
        }
        if (keep)
            b[m++] = b[i];
    }
    return m;
}

// ---------------------------------------------------------------------
// 取判据 d 最大的候选（跨窗合并后的最终选择）
//
// ★ 不用"按面积"：实测跨 9 窗 + thr_d=0 时，贴窗边被裁成大方块的假框
//   （92×90）会把真脸（26×35）压掉，cos 从 0.54 掉到 0.16。
//   与 model/exp_slide_rom.py 的 golden 口径一致（max d）。
// ---------------------------------------------------------------------
int g_pick_best(const gbox_t *b, int n)
{
    int i, best = -1;
    int16_t best_d = -32768;
    for (i = 0; i < n; i++) {
        if (b[i].d > best_d) {
            best_d = b[i].d;
            best = i;
        }
    }
    return best;
}
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
