liaogx2222/riscv-facerec-soc/(commit log)

2026-11-07 Initial commit: RISC-V face-recognition vision SoC on Pango PG2L200H
    - 5-stage dual-issue RV32I core (101.25 MHz) + face-recognition CNN accelerator (202.5 MHz)
    - menu firmware: CoreMark benchmark and access-control pipeline, hold-ack CDC bridge
    - reproducible RTL-to-bitstream flow (PDS 2022.2 synth + 2025.2 PnR)
    - three signed-off bitstreams with STA/resource reports (All Constraints Met)
    - technical report (PDF) and 3-minute slides under docs/
    [_test_vec.h, acc_top.v, acc_top_slide.v, alu.v, btb.v]
2026-11-07 docs: note synthetic frame-ROM placeholder (no portrait data shipped)
